abcuer/freertos_balance_robot_system/Core/Inc/main.h

#define BEEP_Pin GPIO_PIN_13
#define BEEP_GPIO_Port GPIOC
#define ECHO_Pin GPIO_PIN_14
#define ECHO_GPIO_Port GPIOC
#define ECHO_EXTI_IRQn EXTI15_10_IRQn
#define TRIG_Pin GPIO_PIN_15
#define TRIG_GPIO_Port GPIOC
#define MPU_INT_Pin GPIO_PIN_0
#define MPU_INT_GPIO_Port GPIOA
#define Left_IN1_Pin GPIO_PIN_4
#define Left_IN1_GPIO_Port GPIOA
#define Left_IN2_Pin GPIO_PIN_5
#define Left_IN2_GPIO_Port GPIOA
#define Right_IN1_Pin GPIO_PIN_0
#define Right_IN1_GPIO_Port GPIOB
#define Right_IN2_Pin GPIO_PIN_1
#define Right_IN2_GPIO_Port GPIOB
#define MPU_SCL_Pin GPIO_PIN_10
#define MPU_SCL_GPIO_Port GPIOB
#define MPU_SDA_Pin GPIO_PIN_11
#define MPU_SDA_GPIO_Port GPIOB
#define OLED_SCL_Pin GPIO_PIN_12
#define OLED_SCL_GPIO_Port GPIOB
#define OLED_SDA_Pin GPIO_PIN_13
#define OLED_SDA_GPIO_Port GPIOB
#define Follow_Pin GPIO_PIN_14
#define Follow_GPIO_Port GPIOB
#define BlueTooth_Pin GPIO_PIN_15
#define BlueTooth_GPIO_Port GPIOB
#define Balance_Pin GPIO_PIN_8
#define Balance_GPIO_Port GPIOB
#define KEY_Pin GPIO_PIN_9
#define KEY_GPIO_Port GPIOB
