abcuer/freertos_balance_robot_system/Modules/oled/oled_font.c

#include "oled_font.h"

const uint8_t icon_bt[][32*32]=
{
0x00, 0x00, 0x00, 0x00, 0x00, 0x00, 0x00, 0x00, 0x00, 0x1e, 0x00, 0x00, 0x00, 0x3e, 0x00, 0x00, 0x00, 0xfe, 0x00, 0x00, 0x00, 0xfe, 0x01, 0x00, 
0x00, 0xee, 0x03, 0x00, 0x18, 0xce, 0x07, 0x07, 0x3c, 0x8e, 0x0f, 0x0f, 0x7c, 0x8e, 0x0f, 0x0f, 0xf8, 0xce, 0x77, 0x0e, 0xf0, 0xef, 0x73, 0x1e, 
0xe0, 0xef, 0x71, 0x1c, 0xc0, 0xff, 0x70, 0x1c, 0x80, 0x7f, 0xf0, 0x1c, 0x00, 0x3f, 0xf0, 0x1c, 0x00, 0x3f, 0xf0, 0x1c, 0x80, 0x7f, 0x70, 0x1c, 
0xc0, 0xff, 0x70, 0x1c, 0xc0, 0xff, 0x31, 0x1e, 0xe0, 0xef, 0x33, 0x0e, 0xf0, 0xce, 0x07, 0x0f, 0xf8, 0x8e, 0x0f, 0x0f, 0x7c, 0x8e, 0x0f, 0x07, 
0x3c, 0xce, 0x07, 0x00, 0x00, 0xee, 0x03, 0x00, 0x00, 0xfe, 0x01, 0x00, 0x00, 0xfe, 0x00, 0x00, 0x00, 0x7e, 0x00, 0x00, 0x00, 0x3e, 0x00, 0x00, 
0x00, 0x1e, 0x00, 0x00, 0x00, 0x0c, 0x00, 0x00, 
};
