abcuer/freertos_balance_robot_system/(commit log)

2026-03-06 format🥚: rtos架构重构
2026-03-06 perf👌: 完全实现RTOS架构控制
2026-03-07 style💄: 移植 u8g2 oled图形库, 实现了三个模式的UI界面
2026-03-07 style💄: 移植u8g2图形库, 实现三种模式各自的UI, 改进测距逻辑, 减少延时的内存占用
2026-03-07 docs📝: 完善实用指南
2026-03-08 docs📝: 完善食用指南
